aggrc/Egg-Orientation-Device/README.md

# Egg-Orientation-Device
A low-cost, open-source hardware egg orientation device (EOD) for 3D orientation, positioning, and stabilization of zebrafish eggs in preparation for subsequent needle insertion in SCNT applications.
