aggrc/Egg-Orientation-Device/3D print files/Stationery Stage.stl

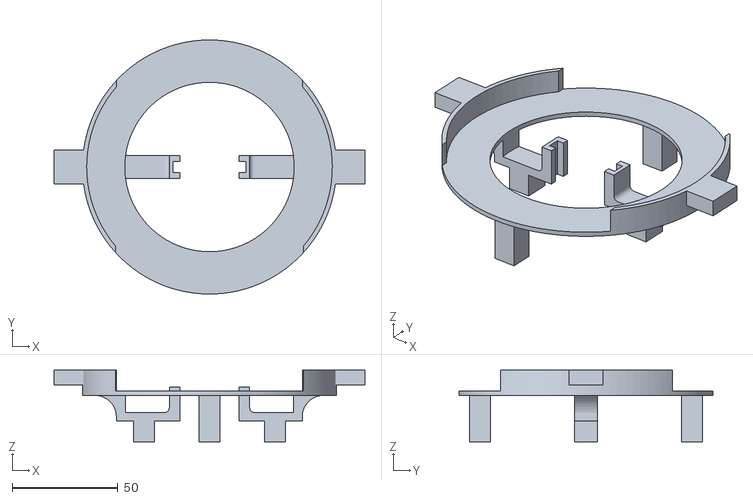
[picture p4: CAD file, 2026-10-07]
3D print files/Stationery Stage.stl
146.9 x 120.0 x 34.0
