aggrc/Egg-Orientation-Device/3D print files/Motor shaft.stl

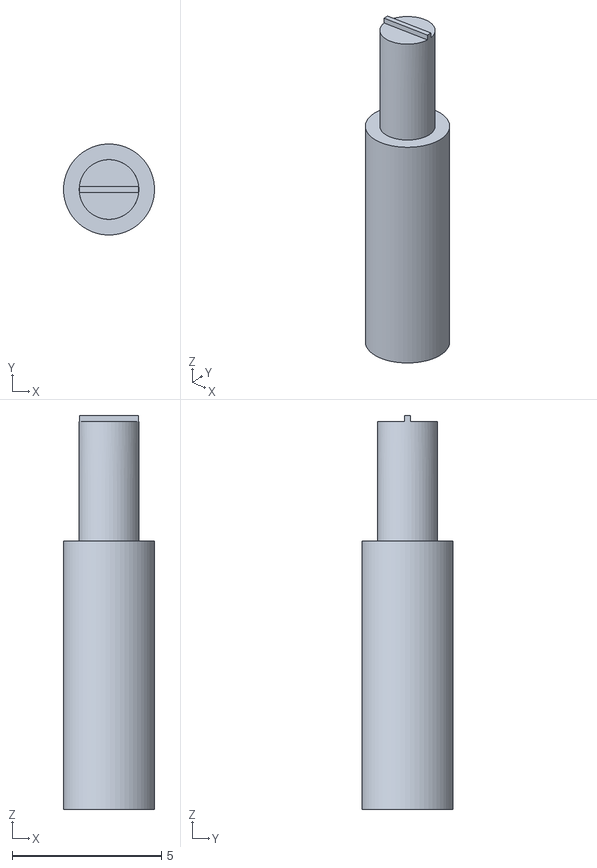
[picture p5: CAD file, 2026-10-07]
3D print files/Motor shaft.stl
3.05 x 3.05 x 13.2
