aggrc/Egg-Orientation-Device/3D print files/Hollow shaft.stl

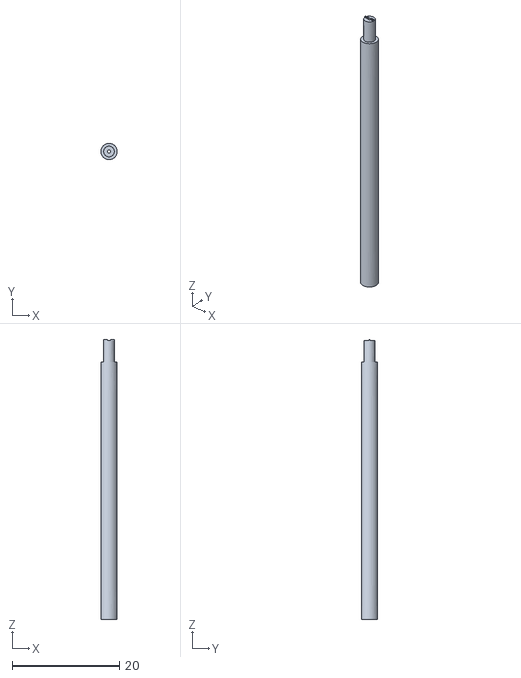
[picture p6: CAD file, 2026-10-07]
3D print files/Hollow shaft.stl
3.05 x 3.05 x 52.2
