aggrc/Egg-Orientation-Device/3D print files/Rotating Stage.stl

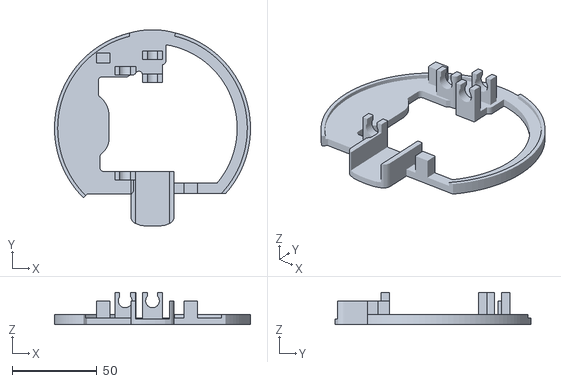
[picture p7: CAD file, 2026-10-07]
3D print files/Rotating Stage.stl
115.8 x 116.1 x 19.0
