aggrc/Egg-Orientation-Device/3D print files/Rod.stl

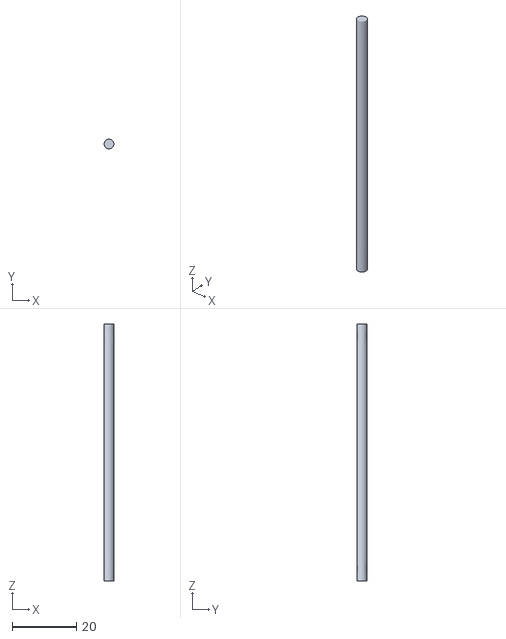
[picture p8: CAD file, 2026-10-07]
3D print files/Rod.stl
3.05 x 3.04 x 80.0
