aggrc/Egg-Orientation-Device/3D print files/Gear.stl

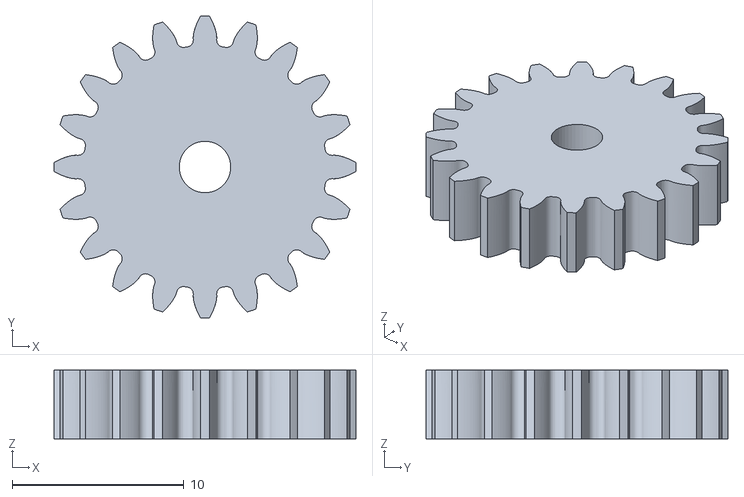
[picture p9: CAD file, 2026-10-07]
3D print files/Gear.stl
17.6 x 17.6 x 4.00
