aggrc/Egg-Orientation-Device/3D print files/ERM.stl

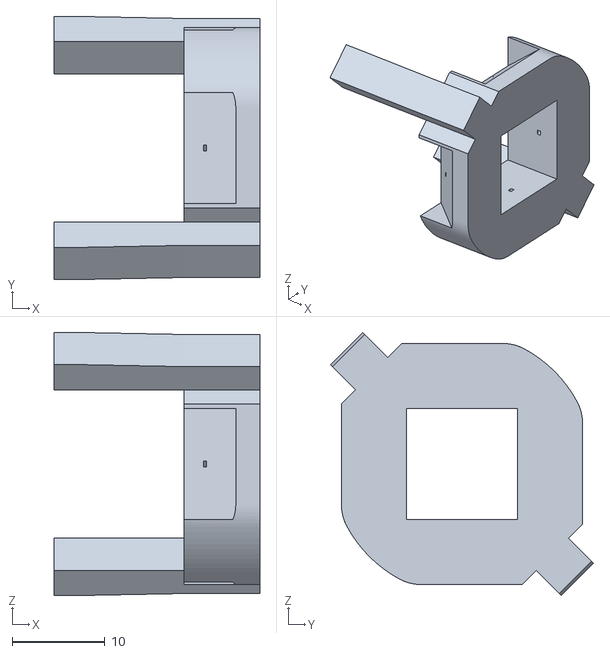
[picture p10: CAD file, 2026-10-07]
3D print files/ERM.stl
22.2 x 28.4 x 28.4
