aggrc/Egg-Orientation-Device/(commit log)

2026-10-07 STL files for 3-D printed components
    [ERM.stl, Gear.stl, Hollow shaft.stl, Motor shaft.stl, Rod.stl, Rotating Stage.stl, Stationery Stage.stl]
2026-10-07 DC motor codes
2026-10-07 Phase splitter Gerber files
    [phase_splitter_Copper_Signal_Bot.gbr, phase_splitter_Copper_Signal_Top.gbr, phase_splitter_Legend_Bot.gbr, phase_splitter_Legend_Top.gbr, phase_splitter_NPTH_Drill.gbr, phase_splitter_PTH_Drill.gbr, phase_splitter_Paste_Bot.gbr, phase_splitter_Paste_Top.gbr]
